slemanz/chronolog/hardware/chronolog.kicad_pcb

## KiCad design hardware/chronolog.kicad_pcb (2026-10-17)

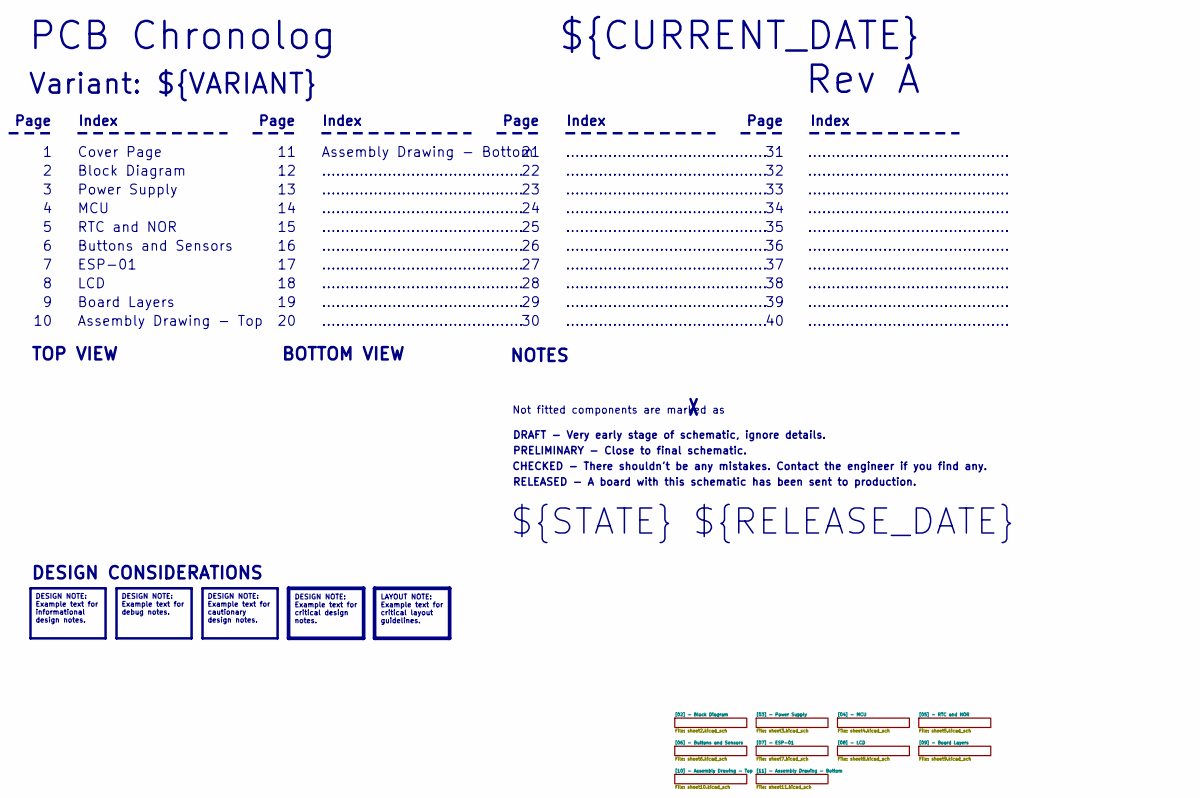
[picture p12: schematic chronolog.kicad_sch, PCB Chronolog]

Notes on the sheet:
Page
Not fitted components are marked as
...........................................
Index
RTC and NOR
BOTTOM VIEW
${STATE} ${RELEASE_DATE}
Board Layers
Rev ${REVISION}
DRAFT - Very early stage of schematic, ignore details.
ESP-01
Cover Page
MCU
NOTES
Variant: ${VARIANT}
PRELIMINARY - Close to final schematic.
LCD
DESIGN CONSIDERATIONS
Block Diagram
Assembly Drawing - Bottom
Assembly Drawing - Top
Buttons and Sensors
Power Supply
${CURRENT_DATE}
RELEASED - A board with this schematic has been sent to production.
${TITLE}
CHECKED - There shouldn't be any mistakes. Contact the engineer if you find any.
TOP VIEW
DESIGN NOTE: Example text for debug notes.
DESIGN NOTE: Example text for cautionary design notes.
LAYOUT NOTE: Example text for critical layout guidelines.
DESIGN NOTE: Example text for critical design notes.
DESIGN NOTE: Example text for informational design notes.

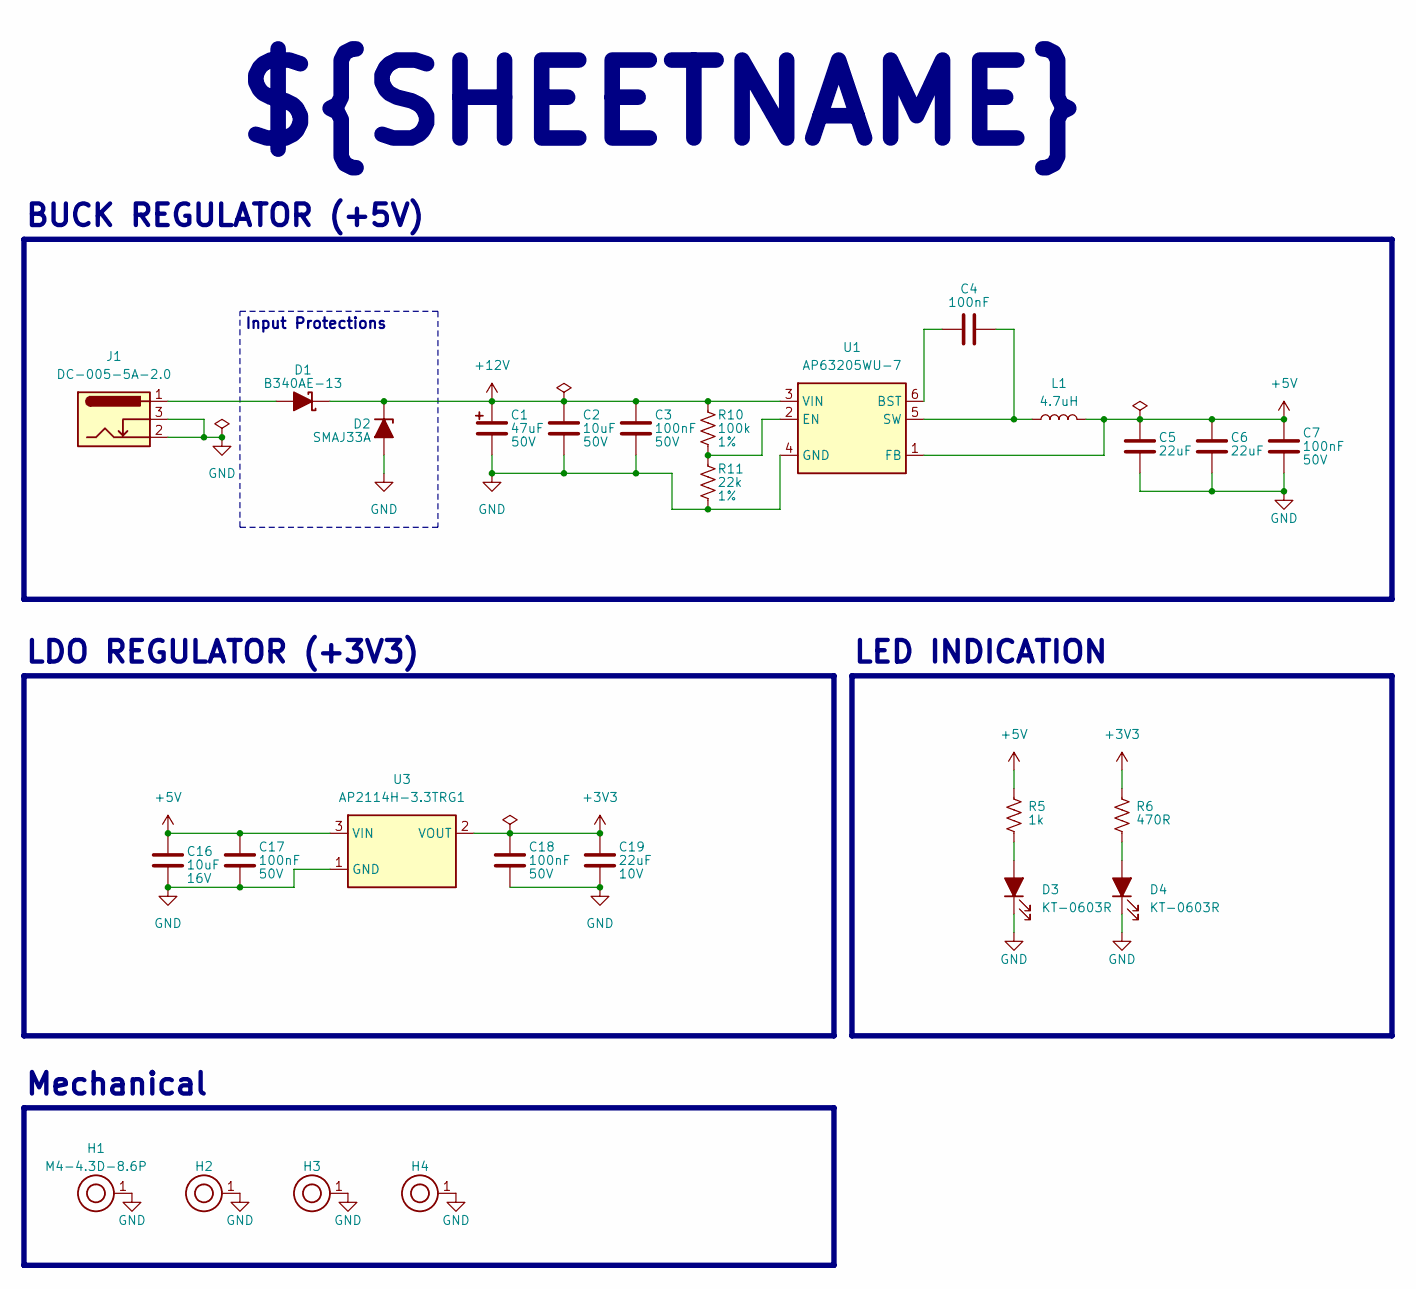
[picture p13: schematic sheet3.kicad_sch, PCB Chronolog]

Parts:
C1: 47uF; CP_Elec_6.3x5.8; Tolerance 20%; Voltage 50V; MPN VZT470M1HTT-0606L; LCSC C46682638
C2: 10uF; C_1210_3225Metric; Tolerance 10%; Voltage 50V; MPN GRM32ER71H106KA12L; LCSC C77102
C3, C4, C7, C17, C18: 100nF; C_0603_1608Metric; Tolerance 10%; Voltage 50V; MPN CC0603KRX7R9BB104; LCSC C14663
C5, C6: 22uF; C_1210_3225Metric; Tolerance 10%; Voltage 25V; MPN CL32B226KAJNNNE; LCSC C309062
C16: 10uF; C_0805_2012Metric; Tolerance 10%; Voltage 16V; MPN GRM21BR61C106KE15L; LCSC C77075
C19: 22uF; C_0805_2012Metric; Tolerance 20%; Voltage 10V; MPN GRM21BR61A226ME51L; LCSC C77074
D1: B340AE-13; D_SMA; MPN B340AE-13; LCSC C168859
D2: SMAJ33A; D_SMA; MPN SMAJ33A; LCSC C223988
D3, D4: KT-0603R; LED_0603_1608Metric; MPN KT-0603R; LCSC C2286
H1, H2, H3, H4: M4-4.3D-8.6P; MountingHole_4.3mm_M4_Pad
J1: DC-005-5A-2.0; TH_DC-005-5A-2.0; MPN DC-005-5A-2.0; LCSC C381116
L1: 4.7uH; L_1008_2520Metric; Tolerance 20%; MPN DFE252012F-4R7M=P2; LCSC C668313
R5: 1k; R_0603_1608Metric; Tolerance 1%; MPN 0603WAF1001T5E; LCSC C21190
R6: 470R; R_0603_1608Metric; Tolerance 1%; MPN 0603WAF4700T5E; LCSC C23179
R10: 100k; R_0603_1608Metric; Tolerance 1%; MPN 0603WAF1003T5E; LCSC C25803
R11: 22k; R_0603_1608Metric; Tolerance 1%; MPN 0603WAF2202T5E; LCSC C31850
U1: AP63205WU-7; TSOT-23-6; MPN AP63205WU-7; LCSC C2071056
U3: AP2114H-3.3TRG1; SOT-223-3_TabPin2; MPN AP2114H-3.3TRG1; LCSC C150716

Connections:
+3V3: C18.1, C19.1, R6.1, U3.2 (VOUT); also elsewhere on the board
+5V: C5.1, C6.1, C7.1, C16.1, C17.1, L1.2, R5.1, U1.1 (FB), U3.3 (VIN); also elsewhere on the board
+12V: C1.1, C2.1, C3.1, D1.1 (K), D2.1 (K), R10.1, U1.3 (VIN)
GND: C1.2, C2.2, C3.2, C5.2, C6.2, C7.2, C16.2, C17.2, C18.2, C19.2, D2.2 (A), D3.1 (K), D4.1 (K), H1.1, H2.1, H3.1, H4.1, J1.2, J1.3, R11.2, U1.4 (GND), U3.1 (GND); also elsewhere on the board
unnamed: D1.2 (A), J1.1
unnamed: D3.2 (A), R5.2
unnamed: D4.2 (A), R6.2
unnamed: C4.1, U1.6 (BST)
unnamed: R10.2, R11.1, U1.2 (EN)
unnamed: C4.2, L1.1, U1.5 (SW)

Notes on the sheet:
BUCK REGULATOR (+5V)
LED INDICATION
Input Protections
${SHEETNAME}
LDO REGULATOR (+3V3)
Mechanical

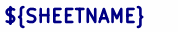
[picture p14: schematic sheet11.kicad_sch, PCB Chronolog]

Notes on the sheet:
${SHEETNAME}

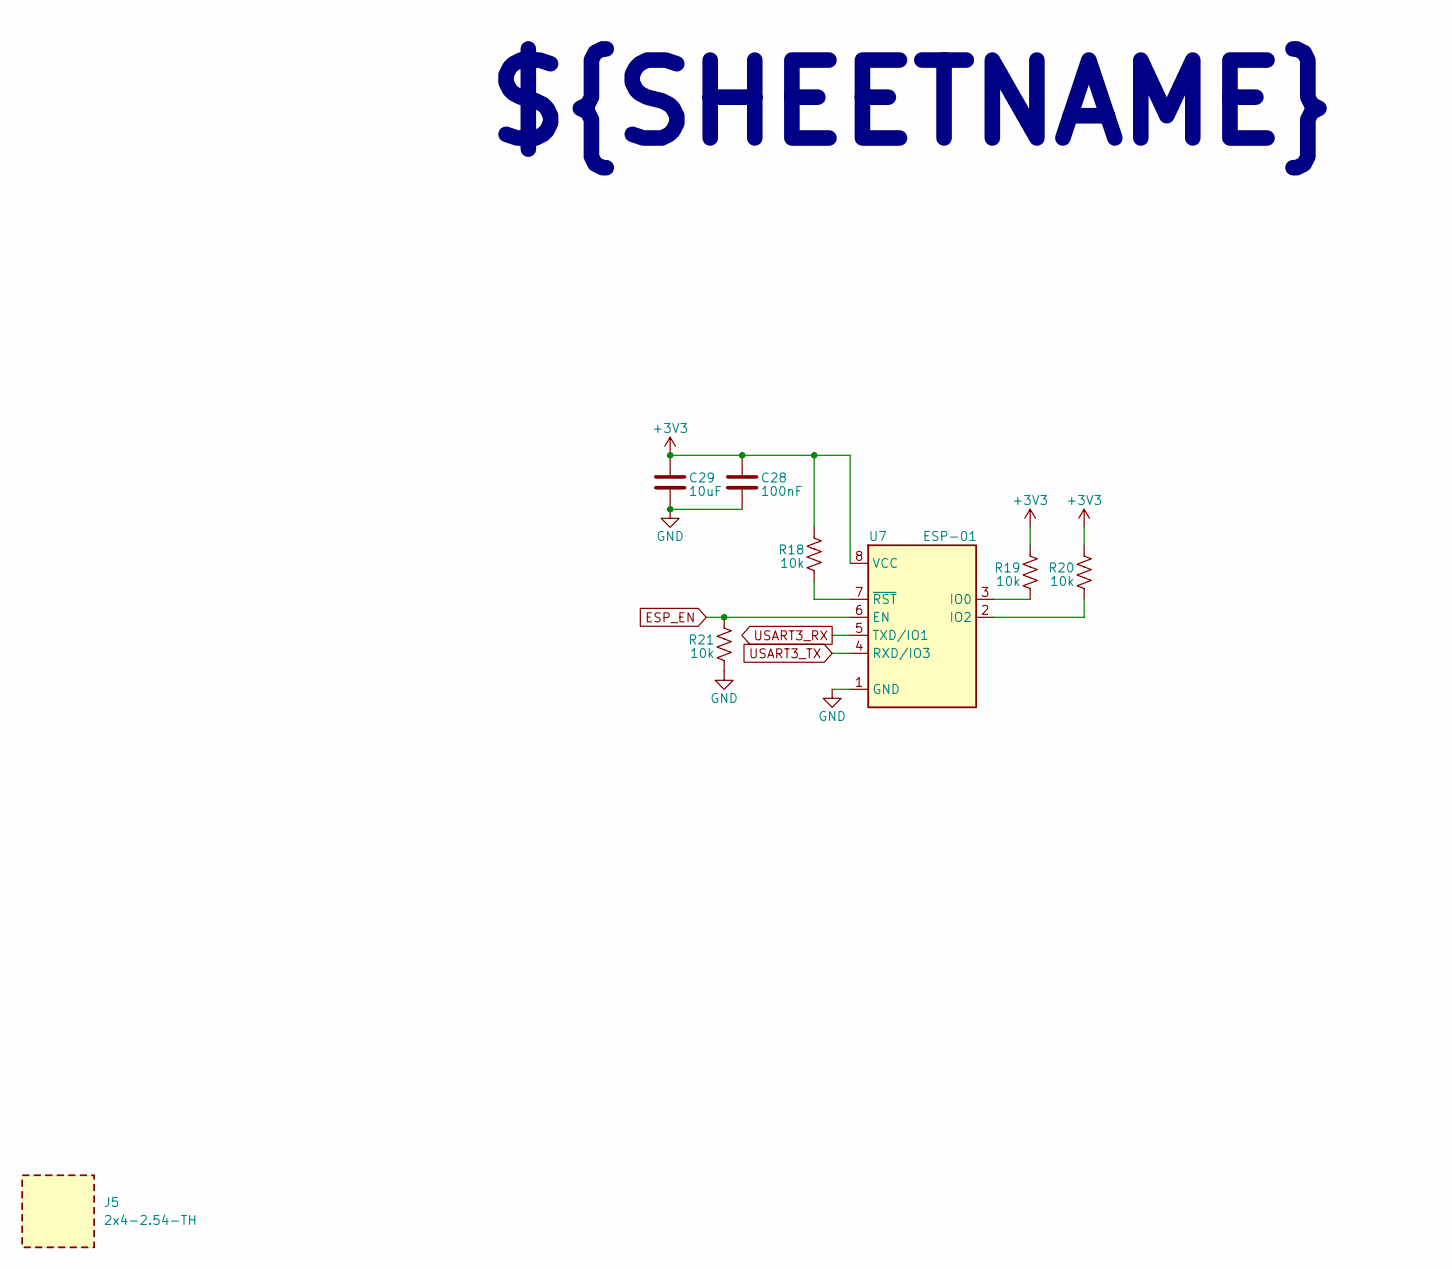
[picture p15: schematic sheet7.kicad_sch, PCB Chronolog]

Parts:
C28: 100nF; C_0603_1608Metric; Tolerance 10%; Voltage 50V; MPN CC0603KRX7R9BB104; LCSC C14663
C29: 10uF; C_0805_2012Metric; Tolerance 10%; Voltage 16V; MPN GRM21BR61C106KE15L; LCSC C77075
J5: 2x4-2.54-TH; MPN PM254-2-04-Z-8.5; LCSC C2897405
R18, R19, R20, R21: 10k; R_0603_1608Metric; Tolerance 1%; MPN 0603WAF1002T5E; LCSC C25804
U7: ESP-01; MPN ESP-01; LCSC C503581

Connections:
+3V3: C28.1, C29.1, R18.1, R19.1, R20.1, U7.8 (VCC); also elsewhere on the board
ESP_EN: R21.1, U7.6 (EN); also elsewhere on the board
GND: C28.2, C29.2, R21.2, U7.1 (GND); also elsewhere on the board
unnamed: R19.2, U7.3 (IO0)
unnamed: R20.2, U7.2 (IO2)
unnamed: R18.2, U7.7 (~RST)
USART3_RX: U7.5 (TXD/IO1); also elsewhere on the board
USART3_TX: U7.4 (RXD/IO3); also elsewhere on the board

Notes on the sheet:
${SHEETNAME}

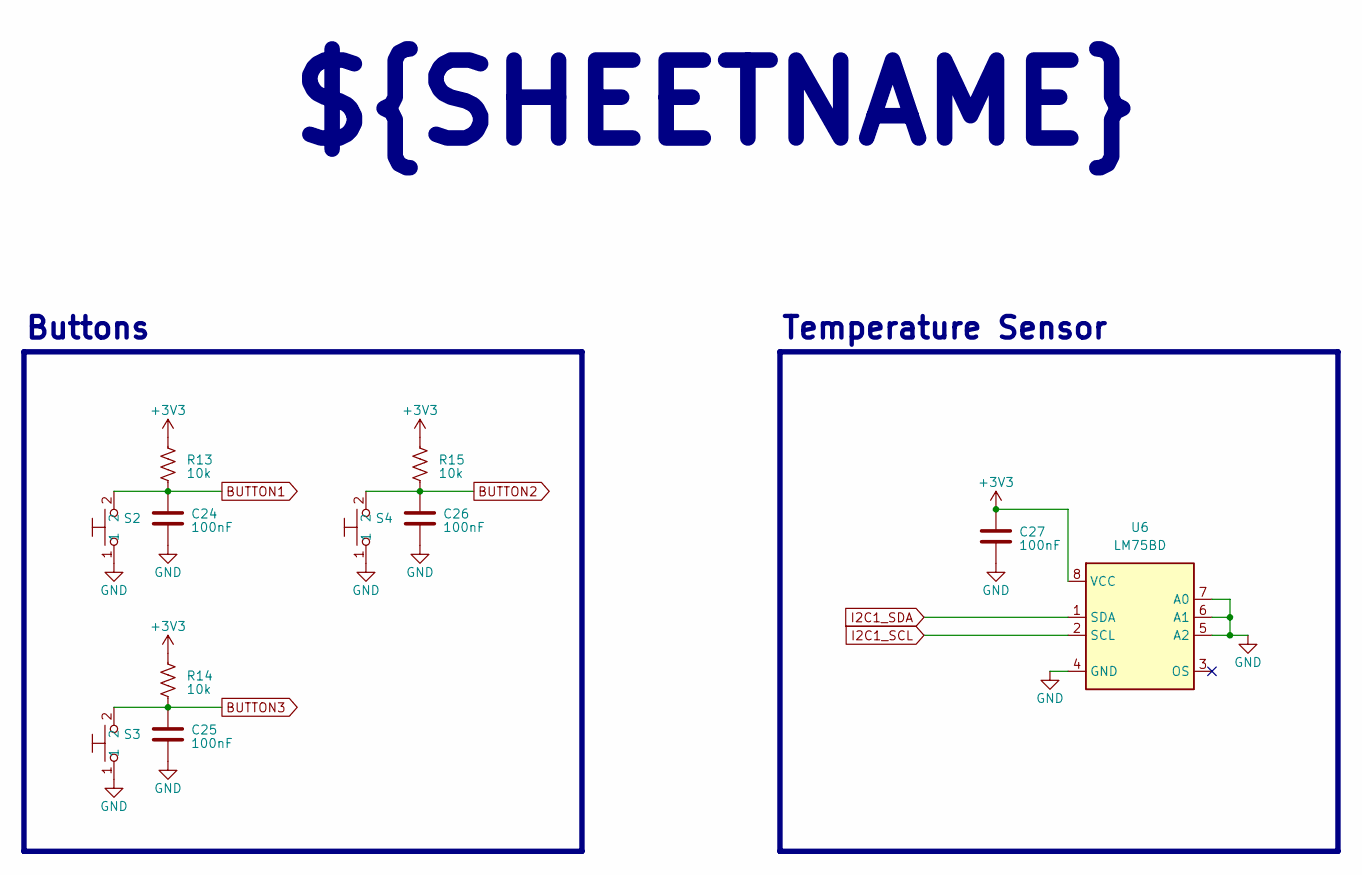
[picture p16: schematic sheet6.kicad_sch, PCB Chronolog]

Parts:
C24, C25, C26, C27: 100nF; C_0603_1608Metric; Tolerance 10%; Voltage 50V; MPN CC0603KRX7R9BB104; LCSC C14663
R13, R14, R15: 10k; R_0603_1608Metric; Tolerance 1%; MPN 0603WAF1002T5E; LCSC C25804
S2, S3, S4: TS-1088-AR02016; SW_SPST_TS-1088-xR020; MPN TS-1088-AR02016; LCSC C720477
U6: LM75BD; SOIC-8_3.9x4.9mm_P1.27mm; MPN LM75BD,118; LCSC C34565

Connections:
+3V3: C27.1, R13.1, R14.1, R15.1, U6.8 (VCC); also elsewhere on the board
BUTTON1: C24.1, R13.2, S2.2; also elsewhere on the board
BUTTON2: C26.1, R15.2, S4.2; also elsewhere on the board
BUTTON3: C25.1, R14.2, S3.2; also elsewhere on the board
GND: C24.2, C25.2, C26.2, C27.2, S2.1, S3.1, S4.1, U6.4 (GND), U6.5 (A2), U6.6 (A1), U6.7 (A0); also elsewhere on the board
I2C1_SCL: U6.2 (SCL); also elsewhere on the board
I2C1_SDA: U6.1 (SDA); also elsewhere on the board

Notes on the sheet:
Buttons
Temperature Sensor
${SHEETNAME}

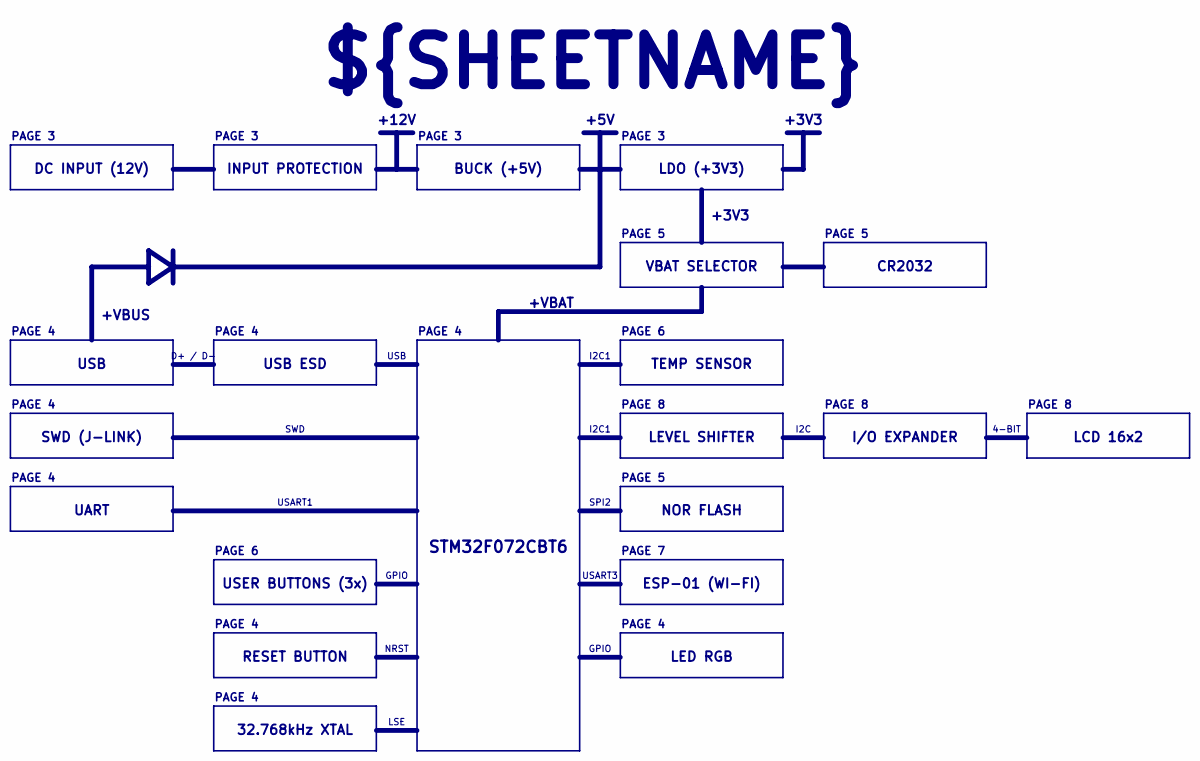
[picture p17: schematic sheet2.kicad_sch, PCB Chronolog]

Notes on the sheet:
PAGE 8
PAGE 3
+VBUS
NOR FLASH
SWD (J-LINK)
VBAT SELECTOR
USB ESD
NRST
PAGE 4
PAGE 6
+12V
INPUT PROTECTION
PAGE 5
DC INPUT (12V)
LED RGB
SPI2
LDO (+3V3)
UART
+5V
D+ / D-
+VBAT
CR2032
GPIO
I/O EXPANDER
USART1
+3V3
${SHEETNAME}
PAGE 7
32.768kHz XTAL
ESP-01 (WI-FI)
SWD
TEMP SENSOR
STM32F072CBT6
LSE
USB
USART3
4-BIT
I2C1
LEVEL SHIFTER
RESET BUTTON
BUCK (+5V)
I2C
LCD 16x2
USER BUTTONS (3x)

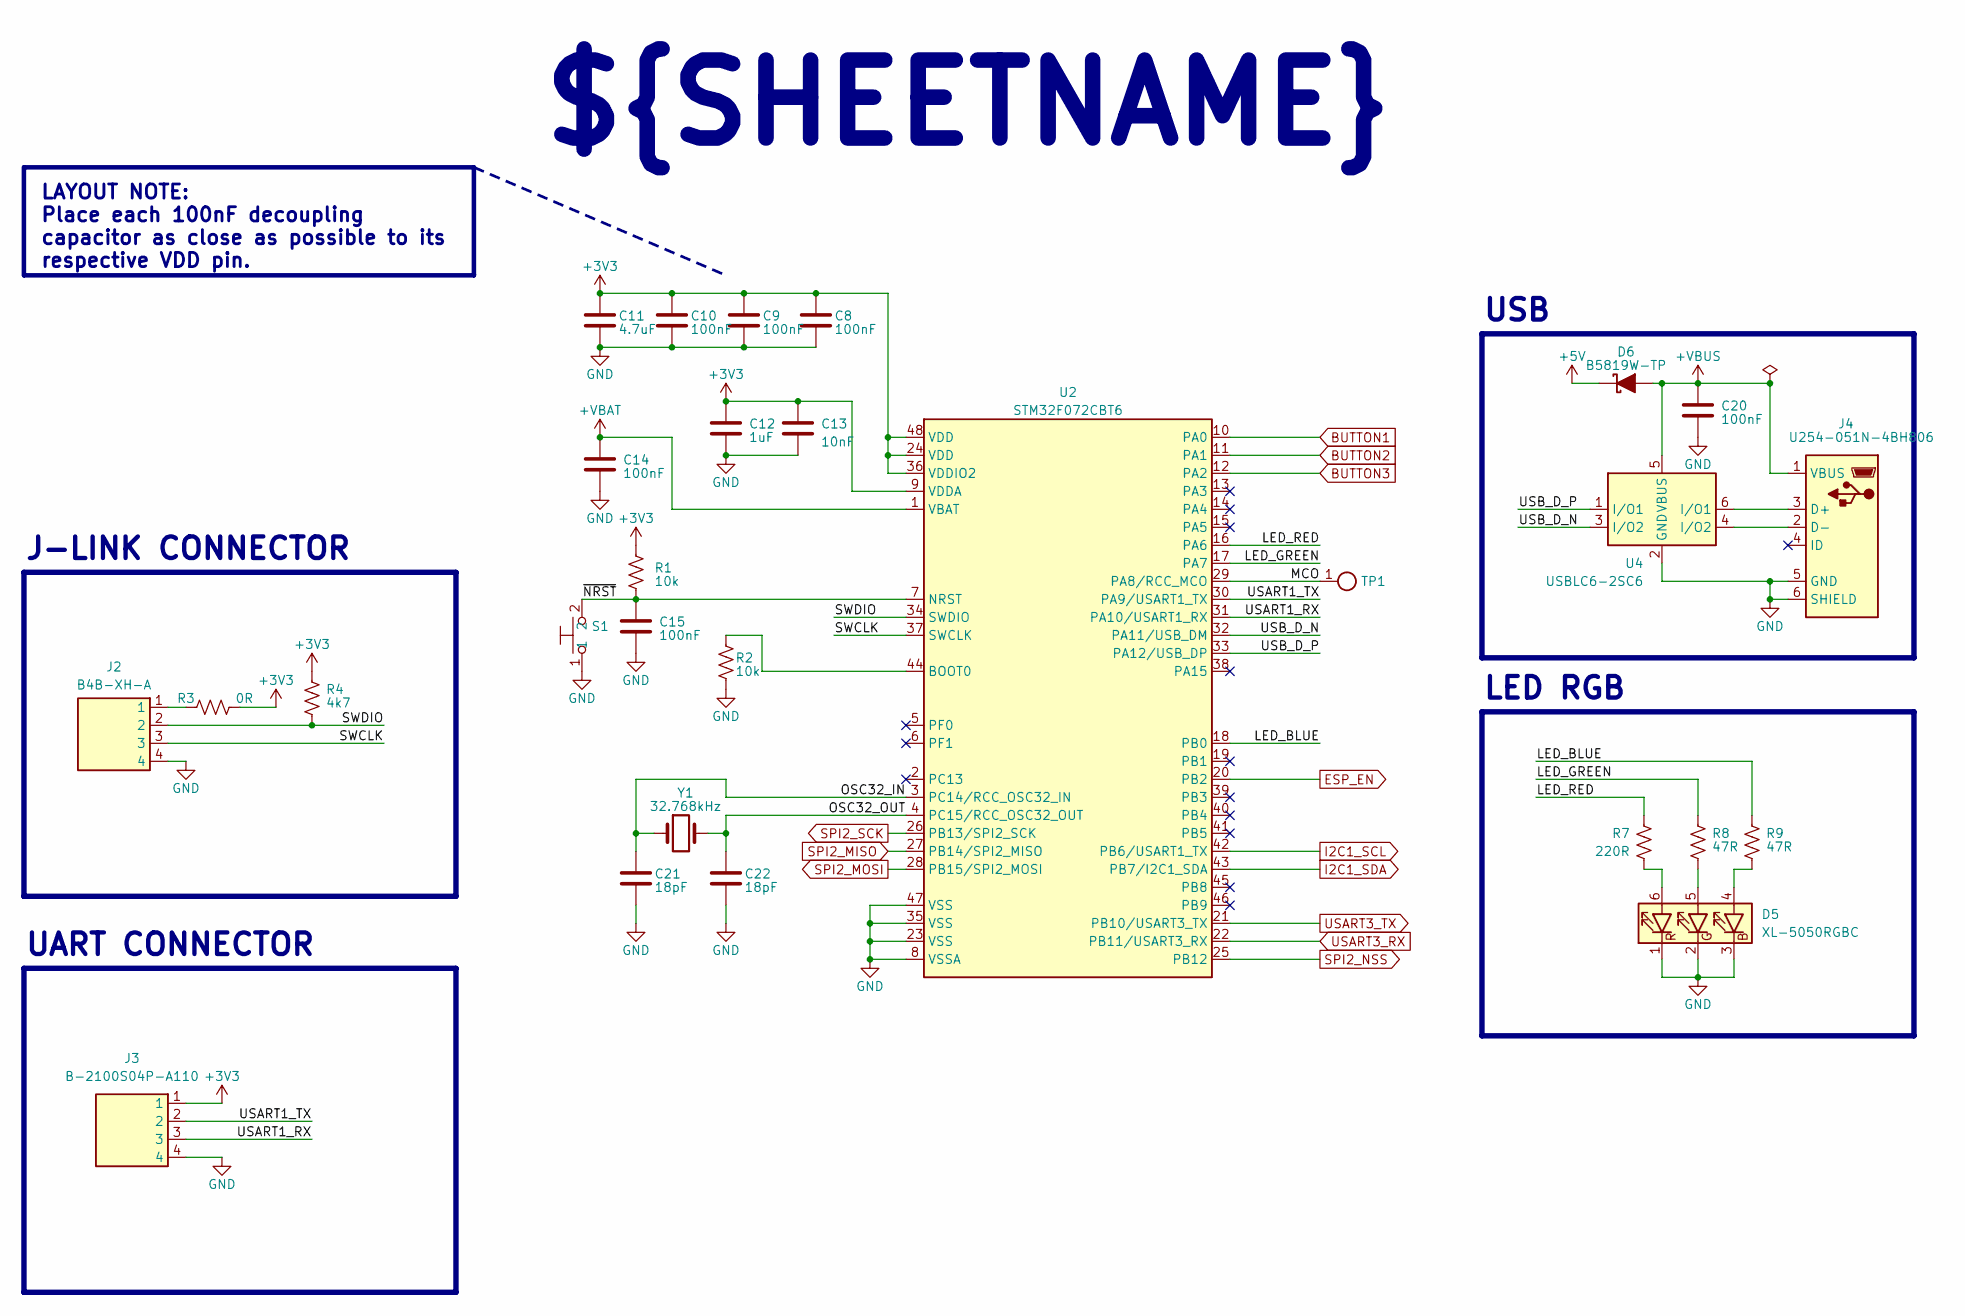
[picture p18: schematic sheet4.kicad_sch, PCB Chronolog]

Parts:
C8, C9, C10, C14, C15, C20: 100nF; C_0603_1608Metric; Tolerance 10%; Voltage 50V; MPN CC0603KRX7R9BB104; LCSC C14663
C11: 4.7uF; C_0603_1608Metric; Tolerance 10%; Voltage 16V; MPN GRM188R61C475KE11D; LCSC C77045
C12: 1uF; C_0603_1608Metric; Tolerance 10%; Voltage 25V; MPN GCM188R71E105KA64D; LCSC C85862
C13: 10nF; C_0603_1608Metric; Tolerance 10%; Voltage 50V; MPN 0603B103K500NT; LCSC C57112
C21, C22: 18pF; C_0603_1608Metric; Tolerance 5%; Voltage 50V; MPN CL10C180JB8NNNC; LCSC C1647
D5: XL-5050RGBC; PLCC-6_XL-5050RGBC; MPN XL-5050RGBC; LCSC C2843868
D6: B5819W-TP; D_SOD-123; MPN B5819W-TP; LCSC C84354
J2: B4B-XH-A; JST_XH_B4B-XH-A_1x04_P2.50mm_Vertical; MPN B4B-XH-A(LF)(SN); LCSC C144395
J3: B-2100S04P-A110; PinHeader_1x04_P2.54mm_Vertical; MPN B-2100S04P-A110; LCSC C124378
J4: U254-051N-4BH806; SMD_U254-051N-4BH806; MPN U254-051N-4BH806; LCSC C319170
R1, R2: 10k; R_0603_1608Metric; Tolerance 1%; MPN 0603WAF1002T5E; LCSC C25804
R3: 0R; R_0603_1608Metric; MPN 0603WAF0000T5E; LCSC C21189
R4: 4k7; R_0603_1608Metric; Tolerance 1%; MPN 0603WAF4701T5E; LCSC C23162
R7: 220R; R_0603_1608Metric; Tolerance 1%; MPN 0603WAF2200T5E; LCSC C22962
R8, R9: 47R; R_0603_1608Metric; Tolerance 1%; MPN 0603WAF470JT5E; LCSC C23182
S1: TS-1088-AR02016; SW_SPST_TS-1088-xR020; MPN TS-1088-AR02016; LCSC C720477
TP1: 1.0P-SMD; TestPoint_Pad_D1.0mm
U2: STM32F072CBT6; LQFP-48_7x7mm_P0.5mm; MPN STM32F072CBT6; LCSC C81720
U4: USBLC6-2SC6; SOT-23-6; MPN USBLC6-2SC6; LCSC C7519
Y1: 32.768kHz; Crystal_SMD_3215-2Pin_3.2x1.5mm; MPN Q13FC1350000400; LCSC C32346

Connections:
+3V3: C8.1, C9.1, C10.1, C11.1, C12.1, C13.1, J3.1, R1.1, R3.2, R4.1, U2.9 (VDDA), U2.24 (VDD), U2.36 (VDDIO2), U2.48 (VDD); also elsewhere on the board
+5V: D6.1 (K); also elsewhere on the board
+VBAT: C14.1, U2.1 (VBAT); also elsewhere on the board
+VBUS: C20.1, D6.2 (A), J4.1 (VBUS), U4.5 (VBUS)
/[04] - MCU/LED_BLUE: R9.1, U2.18 (PB0)
/[04] - MCU/LED_GREEN: R8.1, U2.17 (PA7)
/[04] - MCU/LED_RED: R7.1, U2.16 (PA6)
/[04] - MCU/MCO: TP1.1, U2.29 (PA8/RCC_MCO)
/[04] - MCU/OSC32_IN: C21.1, U2.3 (PC14/RCC_OSC32_IN), Y1.1
/[04] - MCU/OSC32_OUT: C22.1, U2.4 (PC15/RCC_OSC32_OUT), Y1.2
/[04] - MCU/SWCLK: J2.3, U2.37 (SWCLK)
/[04] - MCU/SWDIO: J2.2, R4.2, U2.34 (SWDIO)
/[04] - MCU/USART1_RX: J3.3, U2.31 (PA10/USART1_RX)
/[04] - MCU/USART1_TX: J3.2, U2.30 (PA9/USART1_TX)
/[04] - MCU/USB_D_N: U2.32 (PA11/USB_DM), U4.3 (I/O2)
/[04] - MCU/USB_D_P: U2.33 (PA12/USB_DP), U4.1 (I/O1)
/[04] - MCU/~NRST: C15.1, R1.2, S1.2, U2.7 (NRST)
BUTTON1: U2.10 (PA0); also elsewhere on the board
BUTTON2: U2.11 (PA1); also elsewhere on the board
BUTTON3: U2.12 (PA2); also elsewhere on the board
ESP_EN: U2.20 (PB2); also elsewhere on the board
GND: C8.2, C9.2, C10.2, C11.2, C12.2, C13.2, C14.2, C15.2, C20.2, C21.2, C22.2, D5.1 (RK), D5.2 (GK), D5.3 (BK), J2.4, J3.4, J4.5 (GND), J4.6 (SHIELD), R2.2, S1.1, U2.8 (VSSA), U2.23 (VSS), U2.35 (VSS), U2.47 (VSS), U4.2 (GND); also elsewhere on the board
I2C1_SCL: U2.42 (PB6/USART1_TX); also elsewhere on the board
I2C1_SDA: U2.43 (PB7/I2C1_SDA); also elsewhere on the board
unnamed: D5.4 (BA), R9.2
unnamed: D5.5 (GA), R8.2
unnamed: D5.6 (RA), R7.2
unnamed: J2.1, R3.1
unnamed: J4.3 (D+), U4.6 (I/O1)
unnamed: J4.2 (D-), U4.4 (I/O2)
unnamed: R2.1, U2.44 (BOOT0)
SPI2_MISO: U2.27 (PB14/SPI2_MISO); also elsewhere on the board
SPI2_MOSI: U2.28 (PB15/SPI2_MOSI); also elsewhere on the board
SPI2_NSS: U2.25 (PB12); also elsewhere on the board
SPI2_SCK: U2.26 (PB13/SPI2_SCK); also elsewhere on the board
USART3_RX: U2.22 (PB11/USART3_RX); also elsewhere on the board
USART3_TX: U2.21 (PB10/USART3_TX); also elsewhere on the board

Notes on the sheet:
LED RGB
USB
${SHEETNAME}
J-LINK CONNECTOR
UART CONNECTOR
LAYOUT NOTE: Place each 100nF decoupling capacitor as close as possible to its respective VDD pin.

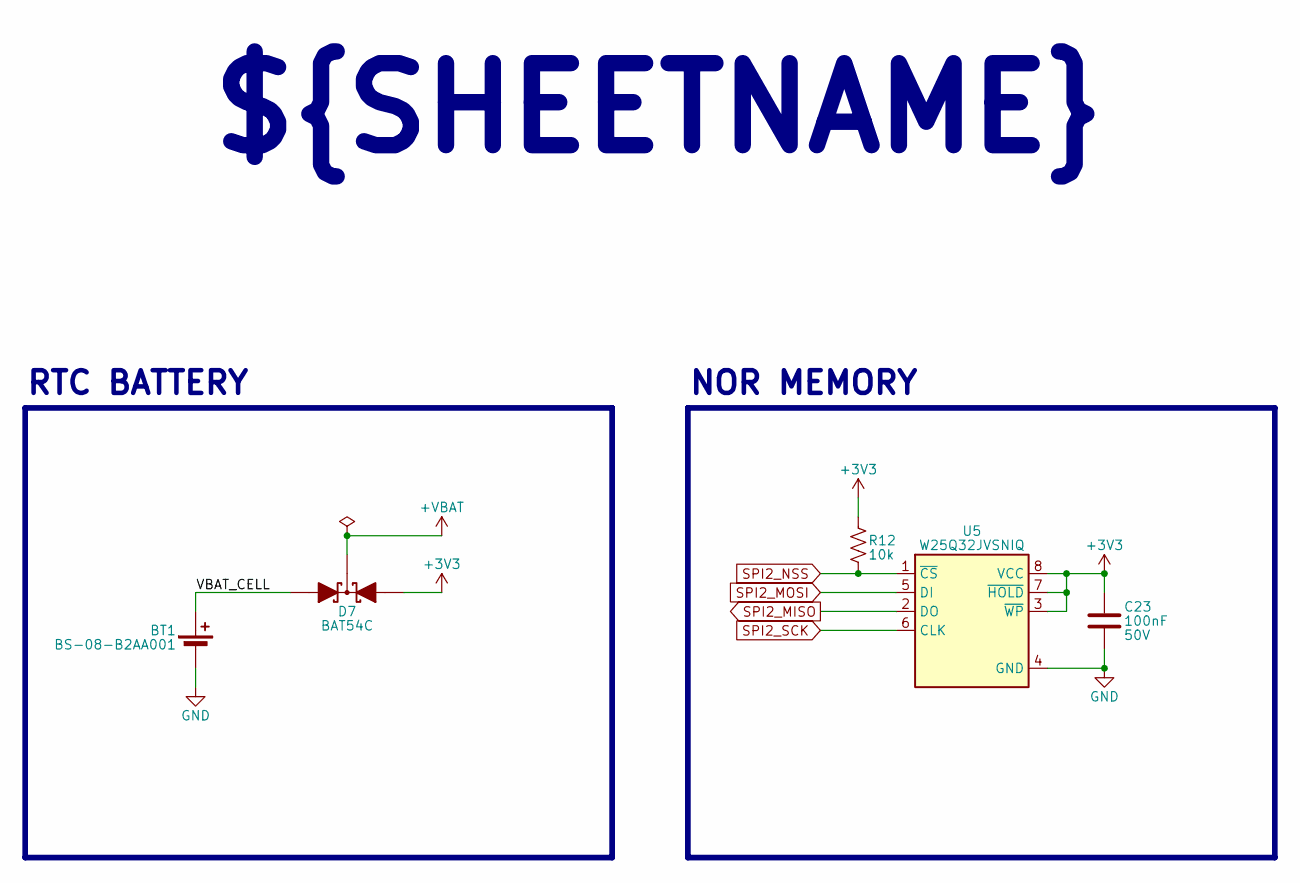
[picture p19: schematic sheet5.kicad_sch, PCB Chronolog]

Parts:
BT1: BS-08-B2AA001; SMD_BS-08-B2AA001; MPN BS-08-B2AA001; LCSC C964777
C23: 100nF; C_0603_1608Metric; Tolerance 10%; Voltage 50V; MPN CC0603KRX7R9BB104; LCSC C14663
D7: BAT54C; SOT-23; MPN BAT54C; LCSC C2135
R12: 10k; R_0603_1608Metric; Tolerance 1%; MPN 0603WAF1002T5E; LCSC C25804
U5: W25Q32JVSNIQ; SOIC-8_3.9x4.9mm_P1.27mm; MPN W25Q32JVSNIQ; LCSC C5355146

Connections:
+3V3: C23.1, D7.1 (A1), R12.1, U5.3 (~WP), U5.7 (~HOLD), U5.8 (VCC); also elsewhere on the board
+VBAT: D7.3 (K); also elsewhere on the board
/[05] - RTC and NOR/VBAT_CELL: BT1.1 (+), D7.2 (A2)
GND: BT1.2 (-), C23.2, U5.4 (GND); also elsewhere on the board
SPI2_MISO: U5.2 (DO); also elsewhere on the board
SPI2_MOSI: U5.5 (DI); also elsewhere on the board
SPI2_NSS: R12.2, U5.1 (~CS); also elsewhere on the board
SPI2_SCK: U5.6 (CLK); also elsewhere on the board

Notes on the sheet:
${SHEETNAME}
NOR MEMORY
RTC BATTERY

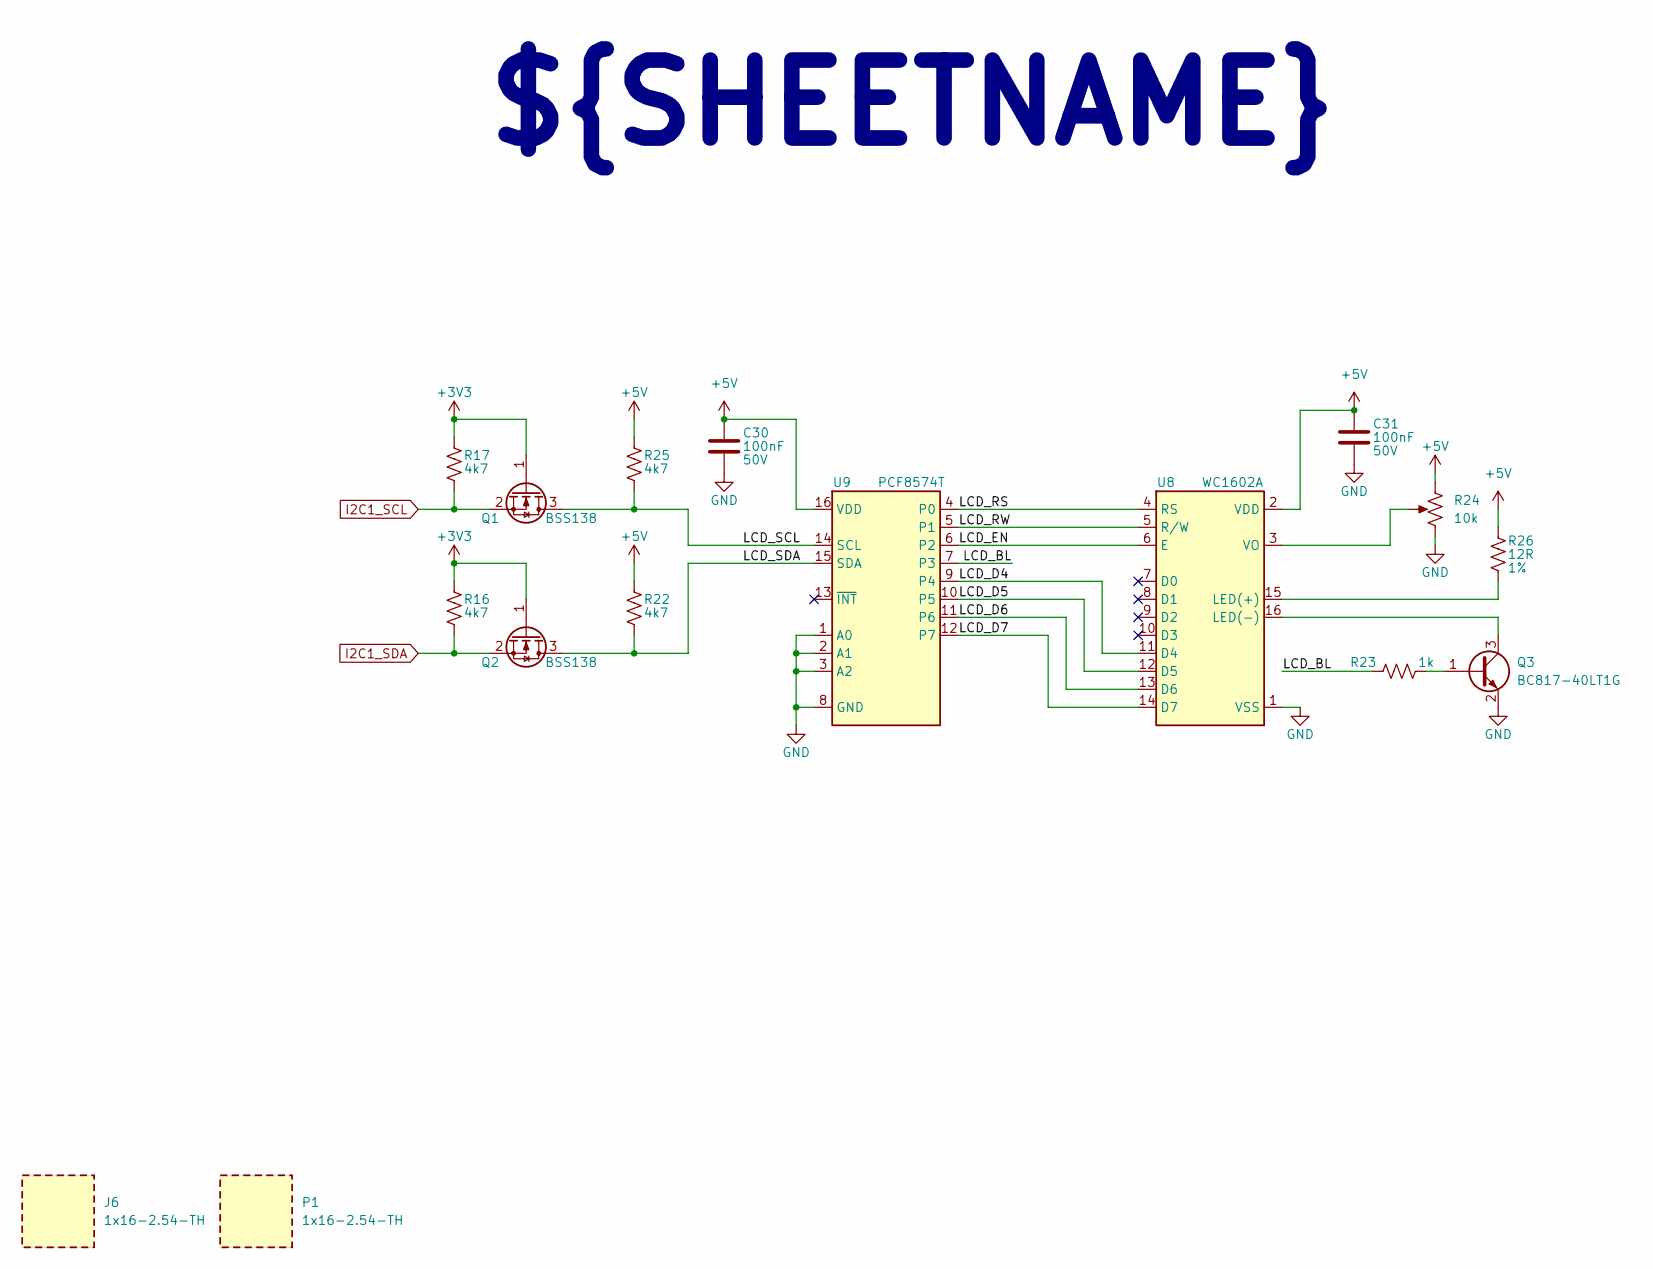
[picture p20: schematic sheet8.kicad_sch, PCB Chronolog]

Parts:
C30, C31: 100nF; C_0603_1608Metric; Tolerance 10%; Voltage 50V; MPN CC0603KRX7R9BB104; LCSC C14663
J6: 1x16-2.54-TH; MPN KH-2.54FH-1X16P-H8.5; LCSC C2905421
P1: 1x16-2.54-TH; MPN B-2100S16P-A110; LCSC C49423290
Q1, Q2: BSS138; SOT-23; MPN BSS138; LCSC C52895
Q3: BC817-40LT1G; SOT-23; MPN BC817-40LT1G; LCSC C94412
R16, R17, R22, R25: 4k7; R_0603_1608Metric; Tolerance 1%; MPN 0603WAF4701T5E; LCSC C23162
R23: 1k; R_0603_1608Metric; Tolerance 1%; MPN 0603WAF1001T5E; LCSC C21190
R24: 10k; TH_3362P; Tolerance 10%; MPN 3362P-1-103LF; LCSC C58159
R26: 12R; R_0805_2012Metric; Tolerance 1%; MPN 0805W8F120JT5E; LCSC C17445
U8: WC1602A; MPN WC1602A; LCSC C5329588
U9: PCF8574T; SOIC-16W_7.5x10.3mm_P1.27mm; MPN PCF8574T; LCSC C7605

Connections:
+3V3: Q1.1 (G), Q2.1 (G), R16.1, R17.1; also elsewhere on the board
+5V: C30.1, C31.1, R22.1, R24.3, R25.1, R26.1, U8.2 (VDD), U9.16 (VDD); also elsewhere on the board
/[08] - LCD/LCD_BL: R23.1, U9.7 (P3)
/[08] - LCD/LCD_D4: U8.11 (D4), U9.9 (P4)
/[08] - LCD/LCD_D5: U8.12 (D5), U9.10 (P5)
/[08] - LCD/LCD_D6: U8.13 (D6), U9.11 (P6)
/[08] - LCD/LCD_D7: U8.14 (D7), U9.12 (P7)
/[08] - LCD/LCD_EN: U8.6 (E), U9.6 (P2)
/[08] - LCD/LCD_RS: U8.4 (RS), U9.4 (P0)
/[08] - LCD/LCD_RW: U8.5 (R/W), U9.5 (P1)
/[08] - LCD/LCD_SCL: Q1.3 (D), R25.2, U9.14 (SCL)
/[08] - LCD/LCD_SDA: Q2.3 (D), R22.2, U9.15 (SDA)
GND: C30.2, C31.2, Q3.2 (E), R24.1, U8.1 (VSS), U9.1 (A0), U9.2 (A1), U9.3 (A2), U9.8 (GND); also elsewhere on the board
I2C1_SCL: Q1.2 (S), R17.2; also elsewhere on the board
I2C1_SDA: Q2.2 (S), R16.2; also elsewhere on the board
unnamed: Q3.1 (B), R23.2
unnamed: Q3.3 (C), U8.16 (LED(-))
unnamed: R26.2, U8.15 (LED(+))
unnamed: R24.2, U8.3 (VO)

Notes on the sheet:
${SHEETNAME}


Notes on the sheet:
${SHEETNAME}

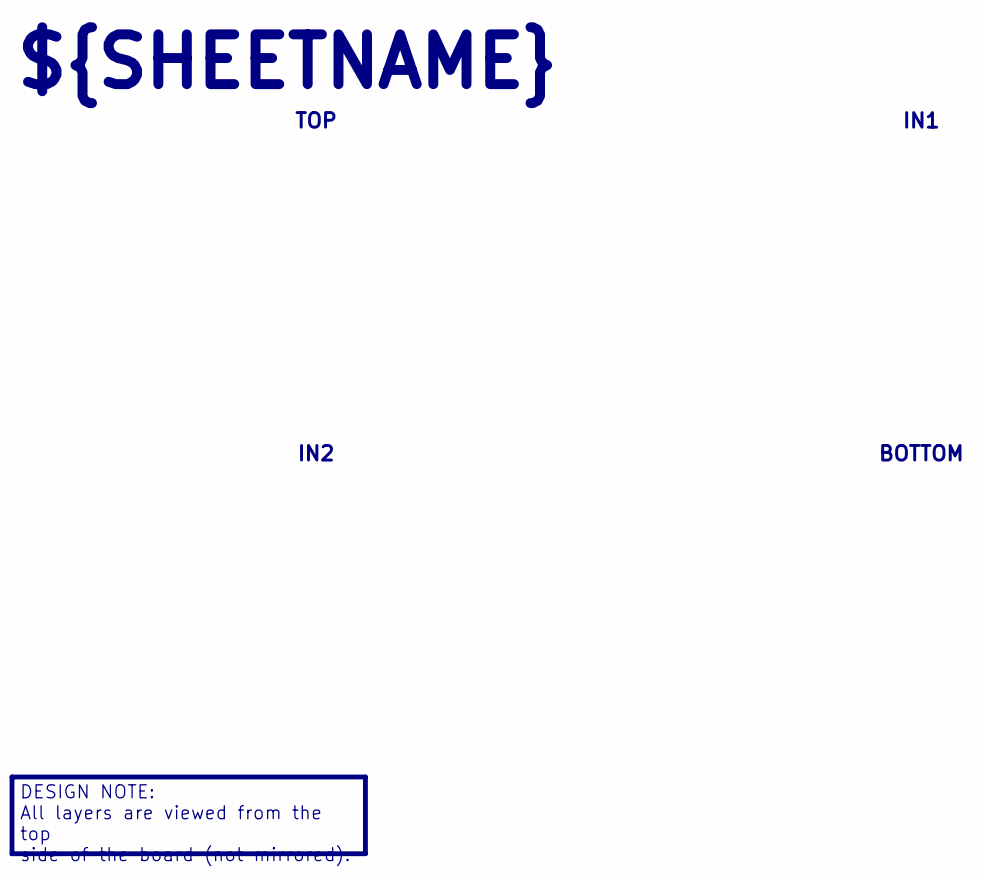
[picture p21: schematic sheet9.kicad_sch, PCB Chronolog]

Notes on the sheet:
IN1
${SHEETNAME}
BOTTOM
TOP
IN2
DESIGN NOTE: All layers are viewed from the top side of the board (not mirrored).

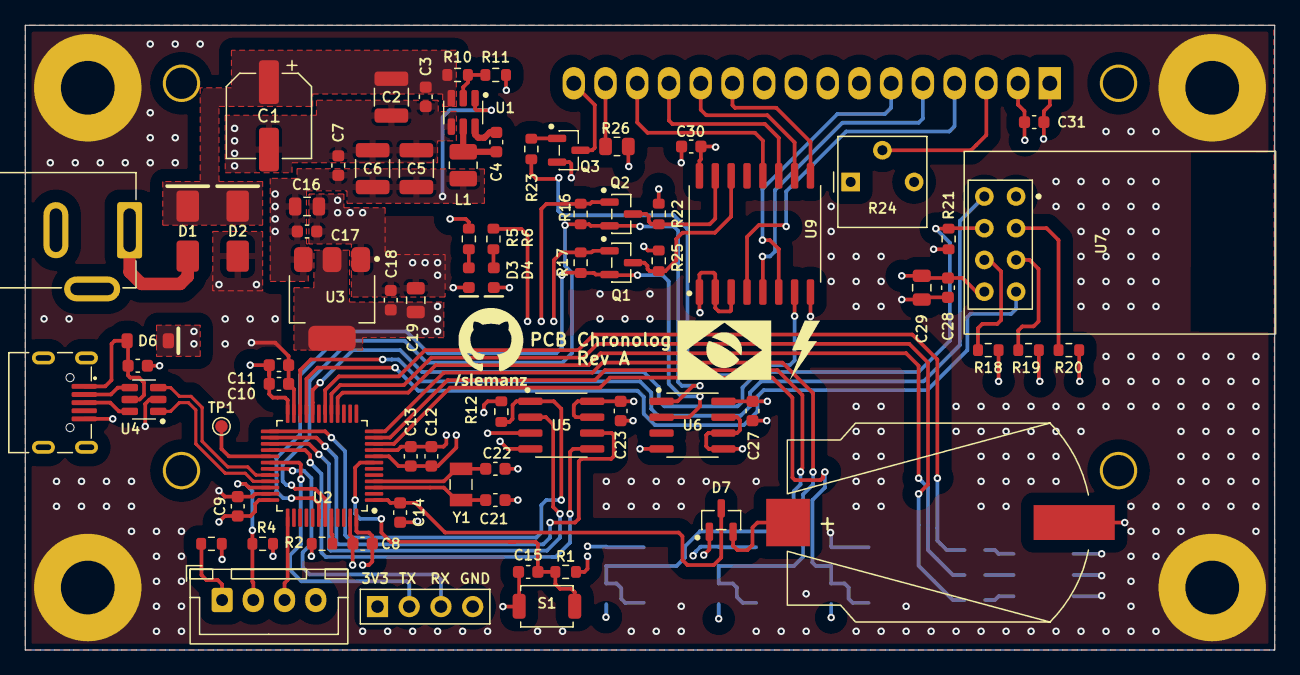
[picture p22: board chronolog.kicad_pcb from above]

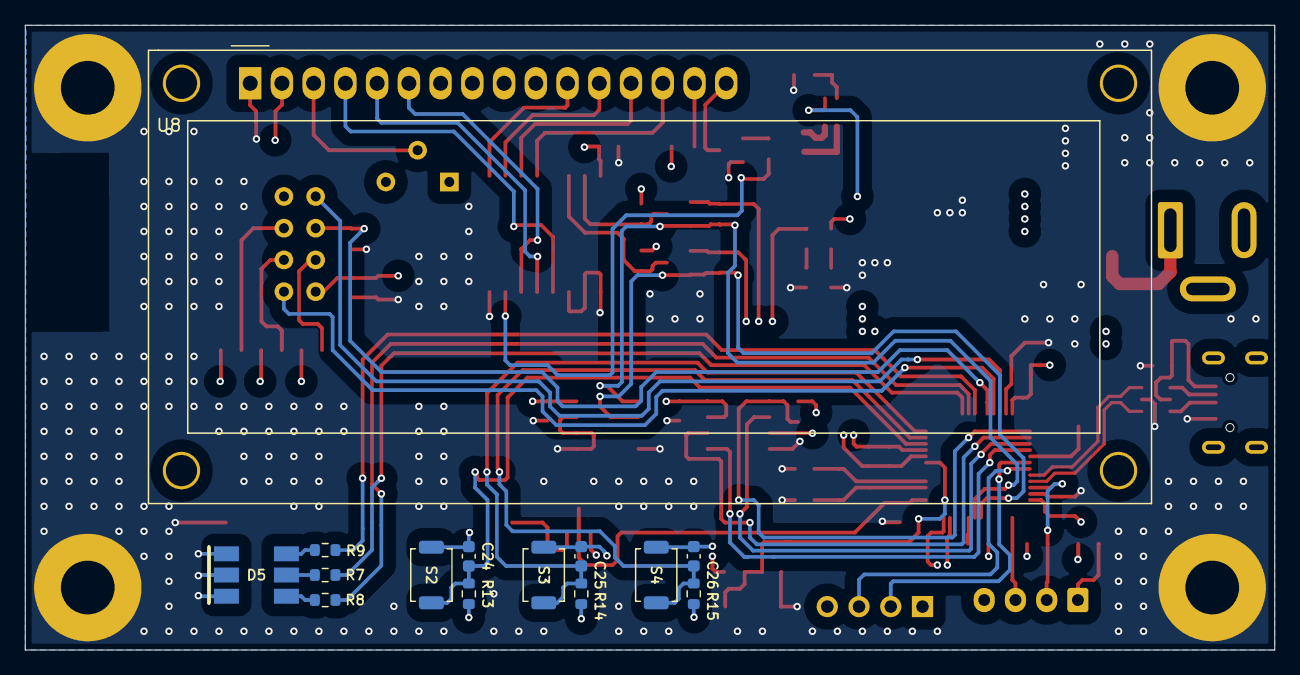
[picture p23: board chronolog.kicad_pcb from below]

Board: 4 copper layers, 100.0 x 50.0 mm, 92 parts (14 on the bottom side), 62 nets.
