slemanz/chronolog/(commit log)

2026-09-22 hardware(feat): add sheets
    [sheet2.kicad_sch, sheet3.kicad_sch]
2026-09-27 hardware(feat): add 4xButton
    [chronolog.kicad_sch, sheet2.kicad_sch, sheet3.kicad_sch]
2026-09-28 hardware(feat): change power budget to power supply
    [chronolog.kicad_sch, sheet3.kicad_sch]
2026-09-28 hardware(feat): add buck regulator
    [sheet3.kicad_sch]
2026-09-29 hardware(feat): add mcu
    [chronolog.kicad_sch, sheet2.kicad_sch, sheet3.kicad_sch, sheet4.kicad_sch]
2026-09-29 hardware(feat): add ldo regulator to +3V3
    [chronolog.kicad_sch, sheet2.kicad_sch, sheet3.kicad_sch, sheet4.kicad_sch]
2026-09-30 hardware(feat): add led indications
    [chronolog.kicad_sch, sheet2.kicad_sch, sheet3.kicad_sch, sheet4.kicad_sch]
2026-10-02 hardware(feat): add usb connector with esd (#1)
    [sheet3.kicad_sch, sheet4.kicad_sch]
2026-10-02 hardware(feat): update schematic
2026-10-03 hardware(feat): add rtc battery and lse crystal (#2)
    [chronolog.kicad_sch, sheet4.kicad_sch, sheet5.kicad_sch]
2026-10-03 hardware(feat): add spi nor flash with cs pull-up and decoupling (#6)
    [sheet4.kicad_sch, sheet5.kicad_sch]
2026-10-04 hardware(feat): add push buttons with pull-ups and debounce (#3)
    [chronolog.kicad_sch, sheet4.kicad_sch, sheet6.kicad_sch]
2026-10-04 hardware(feat): add lm75bd temperature sensor on i2c1 (#4)
    [sheet4.kicad_sch, sheet6.kicad_sch]
2026-10-04 hardware(feat): add esp-01 wifi module on usart3
    [chronolog.kicad_sch, sheet4.kicad_sch, sheet7.kicad_sch]
2026-10-05 hardware(feat): add lcd sheet
    [chronolog.kicad_sch, sheet7.kicad_sch, sheet8.kicad_sch]
2026-10-05 hardware(feat): add 16x2 lcd with pcf8574 on i2c1 (#5)
    [sheet6.kicad_sch, sheet7.kicad_sch, sheet8.kicad_sch]
2026-10-06 hardware(feat): update stm32 pinout
    [chronolog.kicad_sch, sheet2.kicad_sch, sheet3.kicad_sch, sheet4.kicad_sch, sheet5.kicad_sch, sheet6.kicad_sch, sheet7.kicad_sch, sheet8.kicad_sch]
2026-10-06 hardware(feat): update block diagram with page references
    [chronolog.kicad_sch, sheet2.kicad_sch, sheet3.kicad_sch, sheet4.kicad_sch, sheet5.kicad_sch, sheet6.kicad_sch, sheet7.kicad_sch, sheet8.kicad_sch]
2026-10-07 hardware(fix): center sheet titles and unify position and font size
    [sheet2.kicad_sch, sheet3.kicad_sch, sheet6.kicad_sch, sheet7.kicad_sch, sheet8.kicad_sch]
2026-10-07 hardware(feat): import components into pcb
    [chronolog.kicad_pcb]
2026-10-07 hardware(feat): add mounting holes and fiducials
    [chronolog.kicad_pcb, sheet3.kicad_sch]
2026-10-07 hardware(feat): define first board shape and circuit regions
    [chronolog.kicad_pcb]
2026-10-08 hardware(feat): place power supply components
    [chronolog.kicad_pcb]
2026-10-08 hardware(feat): place esp-01, rtc and nor memory
    [chronolog.kicad_pcb]
2026-10-08 hardware(feat): place lcd, lcd driver, mcu, usb, led, buttons and temp sensor
    [chronolog.kicad_pcb]
2026-10-08 hardware(feat): resize the board and reorder circuits
    [chronolog.kicad_pcb]
2026-10-10 project(feat): add kicad-bom-formatter
2026-10-10 hardware(feat): update components symbols and generate the BOM
    [chronolog.csv, chronolog_BOM.xlsx, sheet3.kicad_sch, sheet4.kicad_sch, sheet5.kicad_sch, sheet6.kicad_sch, sheet7.kicad_sch, sheet8.kicad_sch]
2026-10-10 hardware(feat): complete pcb placement, closes #15
    [chronolog.kicad_pcb, sheet3.kicad_sch]
2026-10-11 hardware(feat): configure board stackup and design rules
2026-10-11 hardware(feat): route power supply
2026-10-11 hardware(feat): place internal zones +5V and +3V3
2026-10-11 hardware(feat): route main button, leds and nor connections
2026-10-11 hardware(feat): connect all items in pcb
2026-10-12 hardware(feat): place logos and pcb project name
2026-10-12 hardware(feat): complete pcb routing, closes #16
2026-10-13 hardware(feat): review the board, closes #17
2026-10-13 hardware(feat): add board layers and assembly drawing sheets
2026-10-15 hardware(feat): add board layers
2026-10-16 hardware(feat): add assembly drawing
2026-10-16 hardware(feat): generate final schematic
2026-10-17 hardware(feat): finish pcb fabrication files, closes #18
2026-10-17 hardware(feat): save updates in pcb configuration
